ijinse1993/GetPointOfImpact2D/전체 회로도(schematic).png

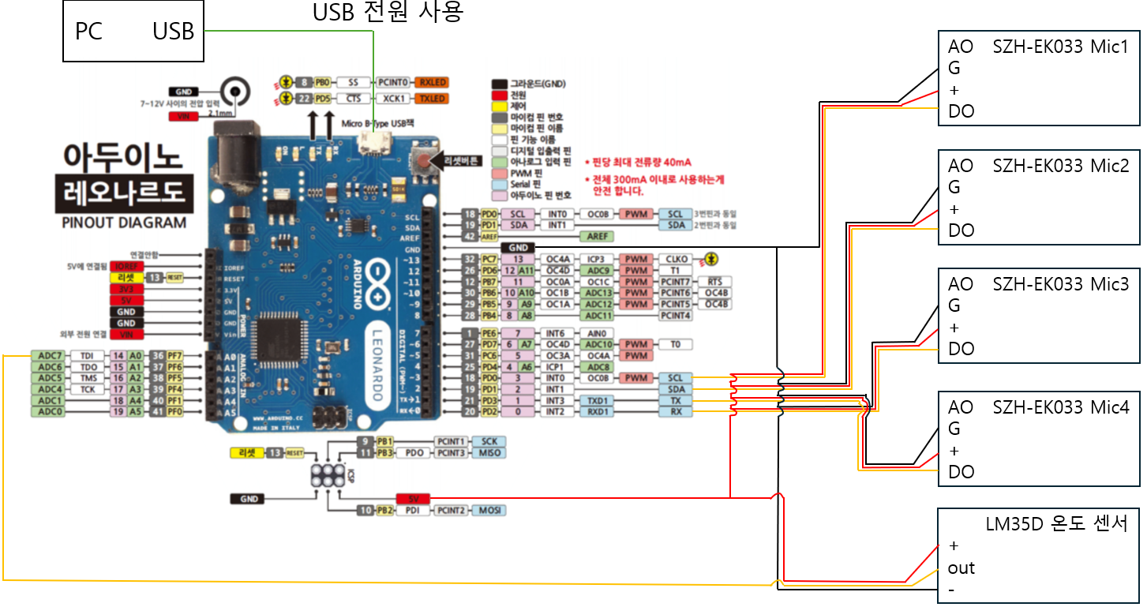
전체 회로도(schematic).png
