ijinse1993/GetPointOfImpact2D/GetPointOfImpact2D_ForLeonardo.ino

#include <math.h>
#include <AbsMouse.h>

#define PIN_DEBUG_CHECK 6
#define CHECK_MIC01_DISTANCE 0
/*
마이크 혹은 가속도센서 설치 위치(반드시 마이크를 탄착판에 밀착하여 설치)
센서 입력은 디지털 on/off 신호로 들어와야함
MIC1--------------------------MIC2
 |              +              |
 |                             |
 |-                           +|
 |                             |
 |              -              |
MIC3--------------------------MIC4
*/

//0,1,2,3,7 사용 가능
#define MIC_COUNT      4						//전체 마이크 갯수 (현재 알고리즘에서는 4개 고정)
#define PIN_MIC1       3            //외부 인터럽트 기능을 위해 고정
#define PIN_MIC2       2            //외부 인터럽트 기능을 위해 고정
#define PIN_MIC3       0            //외부 인터럽트 기능을 위해 고정
#define PIN_MIC4       1            //외부 인터럽트 기능을 위해 고정

//tuning ( * 표시는 필수로 환경에 맞게 변경 필요)
#define MIC_FS (16000000ul/64)              //sampling rate [Hz]
int TimerPrescaleVal = (0 << CS12) | (1 << CS11) | (1 << CS10); //16000000/64
float mic_width                       = 930;				  //마이크가 놓인 직사각형의 너비 [mm]   *
float mic_height                      = 390;          //마이크가 놓인 직사각형의 높이 [mm]   *
float Temperature                     = 22;           //기온, 소리속도 계산 목적이며 USING_LM35D_TEMP_SENSOR옵션이 켜지면 실시간으로 센서를 통해 온도값을 받음 ['C] *
int MonitorWidth                      = 3440;         //주 모니터의 가로 해상도 [pixel]  *
int MonitorHeight                     = 1440;         //주 모니터의 세로 해상도 [pixel]  *
uint32_t DelayForRemoveEcho           = 30;           //충격 인식 후 다시 인식 시작하기까지 딜레이 (잔향 제거)[millisecond]
float WaitAllInputDelay               = 2.05;         //너무 오래된 입력을 사용하지 않기 위한 리셋타임 게인
int MouseClickTime                    = 8;            //마우스 클릭 후 떼기까지 시간 [millisecond]
int MouseClickTimeRandomAmplitude     = 5;            //마우스 클릭 후 떼기까지 시간에 더해질 난수 시간 크기 [millisecond]
int MouseClickButton                  = MOUSE_LEFT;   //마우스 클릭 버튼 (좌클릭:MOUSE_LEFT,우클릭:MOUSE_LEFT,가운데 버튼 클릭:MOUSE_MIDDLE)

#define USING_LM35D_TEMP_SENSOR       1               //1 : LM35D 온도 센서 사용, 0 : 미사용 *
#define TEMP_AVERAGE_COUNT            30
int LM35D_PIN                         = A0;           //온도 센서값을 받을 ADC 핀

float v;                                  //탄착판에서 소리의 전달 속도  [mm/s]
unsigned int MicInputResetTime;           //너무 오래된 입력을 사용하지 않기 위한 리셋타임, WaitAllInputDelay*대각선 길이/v로 계산[sample]
uint32_t MicInputTime[MIC_COUNT];			    //마이크별 충격음을 인식했을 때 시간
char MicInputExist[MIC_COUNT];				    //마이크별 충경 인식 여부 (잔향 제거)
char MicInputCount = 0;                   //충격음을 인식한 마이크 개수
uint32_t NowTime = 0;                     //타이머로 세는 현재시간은 0.26초밖에 못세므로 타이머가 오버플로우로 초기화될때마다
                                          //타이머 시간 누적 계산하여 현재시간 표시
                                          //NowTime의 오버플로우는 30분마다 한번씩 나오므로 처리 안함
char MicInputOrder = 1;                   //마이크 들어온 순서를 쉽게 알기위한 변수


float TempData[TEMP_AVERAGE_COUNT];
int TempIndex = 0;
float TempAccum = 0;

char AdcFlag = 0;
uint16_t AdcVal = 0;

ISR(INT0_vect)
{
  if( MicInputExist[0] == 0 )
  {
    register unsigned int IntTime;
    IntTime = TCNT1;                        //타이머 시간 가져오기 
    MicInputExist[0] = MicInputOrder++;     //마이크 값을 입력 받았다는 표시와 더불어 받은 순서 표시
    MicInputTime[0] = NowTime + IntTime;    //현재 시간에 타이머 시간 추가하여 현재시간 갱신
    MicInputCount++;                        //마이크 받은 갯수 표시
    EIMSK &= 0xFF - (1 << INT0);            //계산 리셋 전까지 이 마이크 추가 입력 받지 않음
  }
}

ISR(INT1_vect)
{
  if( MicInputExist[1] == 0 )
  {
    register unsigned int IntTime;
    IntTime = TCNT1;
    MicInputExist[1] = MicInputOrder++;
    MicInputTime[1] = NowTime + IntTime;
    MicInputCount++;
    EIMSK &= 0xFF - (1 << INT1);
  }
}

ISR(INT2_vect)
{
  if( MicInputExist[2] == 0 )
  {
    register unsigned int IntTime;
    IntTime = TCNT1;
    MicInputExist[2] = MicInputOrder++;
    MicInputTime[2] = NowTime + IntTime;
    MicInputCount++;
    EIMSK &= 0xFF - (1 << INT2);
  }
}

ISR(INT3_vect)
{
  if( MicInputExist[3] == 0 )
  {
    register unsigned int IntTime;
    IntTime = TCNT1;
    MicInputExist[3] = MicInputOrder++;
    MicInputTime[3] = NowTime + IntTime;
    MicInputCount++;
    EIMSK &= 0xFF - (1 << INT3);
  }
}

ISR(TIMER1_OVF_vect)
{
  NowTime += 0x10000; //오버플로우 후니 0xFFFF가 아니라 0x10000이 맞는것 같음
	//NowTime변수의 오버플로우는 30분에 한번씩 발생하니 처리 안함

  #if USING_LM35D_TEMP_SENSOR
  if( ADCSRA & (1<<ADIF) )
  {
    AdcVal = ADC;
    AdcFlag = 1;
    ADCSRA |= (1<<ADIF);  //flag clear
    ADCSRA |= (1<<ADSC);  //ADC start
  }
  #endif
}

void InputOff()
{
  EIMSK = 0;  //인터럽트 금지
  TIMSK1 = 0;
}

void CalculateReset()
{
	int i;
  EIMSK = 0;  //인터럽트 금지
  TIMSK1 = 0;

  //현재 시간과 마이크 입력 여부 초기화
	for(i = 0 ;i < MIC_COUNT;i++) MicInputExist[i] = 0;
	NowTime = 0;
	MicInputCount = 0;
  MicInputOrder = 1;

  //External int 기존 입력 제거
  EIFR |= (1 << INTF3) | (1 << INTF2) | (1 << INTF1) | (1 << INTF0);

  //타이머 카운트 초기화
  TCCR1B &= 0xFF - ((1 << CS12) | (1 << CS11) | (1 << CS10));	//타이머 종료
  TCNT1 = 0;
  TIFR1 |= (1 << TOV1);
  TCCR1B |= TimerPrescaleVal;  //타이머 재시작

  //인터럽트 허용
  EIMSK = (1<<INT3) | (1<<INT2) | (1<<INT1) | (1<<INT0);
  TIMSK1 |= (0 << ICIE1) | (0 << OCIE1B) | (0 << OCIE1A) | (1 << TOIE1);		//
}

float TempMoveMean(float Temp)
{
  TempAccum -= TempData[TempIndex];
  TempData[TempIndex] = Temp / TEMP_AVERAGE_COUNT;
  TempAccum += TempData[TempIndex];
  TempIndex++;
  if(TempIndex >= TEMP_AVERAGE_COUNT) TempIndex = 0;
  return TempAccum;
}

void setup()
{
  int i;
  delay(100);

  randomSeed(analogRead(0));

  cli();    //모든 인터럽트 금지
  for(i = 0 ;i < MIC_COUNT;i++) MicInputExist[i] = 0;
	NowTime = 0;
	MicInputCount = 0;
  
  //마이크 입력핀 입력 모드
  pinMode(PIN_MIC1, INPUT);
  pinMode(PIN_MIC2, INPUT);
  pinMode(PIN_MIC3, INPUT);
  pinMode(PIN_MIC4, INPUT);
  //pinMode(PIN_DEBUG_CHECK, OUTPUT);

  //디버그용 시리얼 초기화
  Serial.begin(250000);

  //External int 초기화
  //INT0, INT1 , INT2, INT3 rising edge 검출
																												  
  
											   
	EICRA = (1<<ISC31) | (0<<ISC30) | (1<<ISC21) | (0<<ISC20) | (1<<ISC11) | (0<<ISC10) | (1<<ISC01) | (0<<ISC00);
  EICRB = 0;
	EIMSK = (1<<INT3) | (1<<INT2) | (1<<INT1) | (1<<INT0);  //인터럽트 허용

  //타이머 초기화
  //normal모드, 오버플로우 인터럽트 허용
  //prescale 64 : 250kHz
  TCCR1A = (0 << WGM11) | (0 << WGM10);
  TCCR1B = (0 << ICNC1) | (0 << ICES1) | (0 << WGM13) | (0 << WGM12);
  TCCR1C = 0;
  TCNT1 = 0;
  TIMSK1 = (0 << ICIE1) | (0 << OCIE1B) | (0 << OCIE1A) | (1 << TOIE1);		//
  TCCR1B |= TimerPrescaleVal;

  sei();  //인터럽트 허용

  #if USING_LM35D_TEMP_SENSOR
  analogReference(DEFAULT);

  for(i = 0; i < TEMP_AVERAGE_COUNT; i++)
  {
    AdcVal = analogRead(LM35D_PIN);

    //읽어 들인 값을 현재 섭씨 온도값으로 변환한다.
    Temperature = TempMoveMean((5.0 * AdcVal * 100.0)/1024);
    delay(10);
  }
  ADCSRA |= (1<<ADIF);  //flag clear
  ADCSRA |= (1<<ADSC);  //ADC start
  #endif

  //기온을 이용하여 공기중 소리 속도 계산
  v = 1000 * 331.3 * sqrt( (Temperature+273.15) / 273.15 );
  //v = 487680;

  //너무 오래된 입력을 사용하지 않기 위한 리셋타임[second]
  //외부 노이즈로 마이크중 일부만 소리가 입력되었다고 인식되었을 때 이 입력을 지워주기 위함
  //가장 먼 거리인 대각선 거리보다 1.05배 긴 거리의 시간차보다 더 오래된 신호가 있으면 기존 입력 초기화
  MicInputResetTime = (unsigned int)(
    WaitAllInputDelay * sqrt(mic_width*mic_width + mic_height*mic_height)
    * (MIC_FS / v) + 0.5
  );

  //PC에 절대값 마우스 입력을 위한 라이브러리 초기화
  AbsMouse.init(MonitorWidth, MonitorHeight);
}

void CalculatePos(float t01, float t23, float t02, float width, float height, int *x, int *y)
{
  float X, Y, tmp;

  if( (abs(t01) < 1e-8) || (abs(t23) < 1e-8) )												//탄착점이 Y축 위에 존재
	{
		float S;
		X = 0.0;

		S = v*v*t02*t02;
		tmp = ((height*height+width*width)*S-S*S) / (4*height*height-4*S);
		if(tmp < 0)
  	{
			tmp = 0;
		}

		if(t02 > 0) Y = -sqrt( tmp );
		else Y = sqrt( tmp );
  }else if( (abs(t02) < 1e-8) || (abs(t01-t23) < 1e-8) )							//탄착점이 X축 위에 존재
	{
		float S;
		Y = 0;

		S = v*v*t23*t23;
		tmp = ((width*width+height*height)*S-S*S) / (4*width*width-4*S);
		if(tmp < 0)
		{
			tmp = 0;
		}

		if(t23 > 0) X = sqrt( tmp );
		else X = -sqrt( tmp );
	}else{
    float algo_A1,algo_B1,algo_A2,algo_B2, alpha, beta, gamma;
  
		algo_A1 = t01 * t01;
		algo_A2 = t23 * t23;
		algo_B1 = ( 4 * algo_A1 ) / ( width*width - v*v*algo_A1 );
		algo_B2 = ( 4 * algo_A2 ) / ( width*width - v*v*algo_A2 );
		alpha = algo_B1 - algo_B2;
		beta = -height * (algo_B1 + algo_B2);
		gamma = (algo_B1 - algo_B2) * height * height / 4 + algo_A1 - algo_A2;

		tmp = beta*beta-4*alpha*gamma;
		if(tmp < 0)
		{
			tmp = 0;
		}
		Y = (-beta - sqrt( tmp ) ) / (2 * alpha);

		tmp = 1 + ( 4 * (Y-height/2)*(Y-height/2) / ( width*width-v*v*t01*t01) );
		if(tmp < 0)
		{
			tmp = 0;
		}

		X = v*t01*sqrt( tmp ) / 2;
	}

  if(x)
  {
    *x = (int)(X+0.5);
	  if( *x > width/2)		*x = width/2;      //결과값 최대치 제한
	  else if( *x < -width/2)	*x = -width/2;
  }
		
  if(y)
  {
    *y = (int)(Y+0.5);
    if( *y > height/2)	*y = height/2;      //결과값 최대치 제한
		else if( *y < -height/2)	*y = -height/2;
  }
}

void loop()
{
  #if USING_LM35D_TEMP_SENSOR
  if(AdcFlag)
  {
    AdcFlag = 0;
    //읽어 들인 값을 현재 섭씨 온도값으로 변환한다.
    Temperature = TempMoveMean( (5.0 * AdcVal * 100.0)/1024 );
    v = 1000 * 331.3 * sqrt( (Temperature+273.15) / 273.15 );
    //Serial.println(Temperature);
  }
  #endif

  if(MicInputCount >= MIC_COUNT)
	{
    int i;
    float t01, t23, t02, t13;
    int32_t tmp2;
    int x, y;
    InputOff();
    //digitalWrite(PIN_DEBUG_CHECK, HIGH);

    #if CHECK_MIC01_DISTANCE
    //------------------마이크 시간차 계산
    tmp2 = MicInputTime[0] - MicInputTime[1];
		//t01 = tmp2 * v / MIC_FS;
    //Serial.println(t01);
    t01 = mic_width / tmp2 * MIC_FS;
    Serial.println(t01);
    //-----------------------------------
		#else

    //------------------탄착 지점 계산 코드
    //x축 연산 결과는 잘맞으나 y축 연산 결과는 영 잘맞지 않아 x축 좌표를 구하고 90도 돌려서 다시 x축 좌표를 구하는것으로
    //y축 좌표 계산함
    tmp2 = MicInputTime[0] - MicInputTime[1];
		t01 = ((float)tmp2) / MIC_FS;
    tmp2 = MicInputTime[2] - MicInputTime[3];
		t23 = ((float)tmp2) / MIC_FS;
    tmp2 = MicInputTime[0] - MicInputTime[2];
		t02 = ((float)tmp2) / MIC_FS;

    CalculatePos(t01, t23, t02, mic_width, mic_height, &x, (int *)0);
    //-----------------------------------
    //3 -> 1
		//1 -> 2
		//4 -> 3
		//2 -> 4
    tmp2 = MicInputTime[2] - MicInputTime[0];
		t01 = ((float)tmp2) / MIC_FS;
    tmp2 = MicInputTime[3] - MicInputTime[1];
		t23 = ((float)tmp2) / MIC_FS;
    tmp2 = MicInputTime[2] - MicInputTime[3];
		t02 = ((float)tmp2) / MIC_FS;

    CalculatePos(t01, t23, t02, mic_height, mic_width, &y, (int *)0);

    #if 0
    Serial.print("X:");
    Serial.println(x);
    Serial.print("Y:");
    Serial.println(y);
    #else
    AbsMouse.move(
      (uint16_t)((x + mic_width/2) * MonitorWidth / mic_width + 0.5),
      (uint16_t)((mic_height/2 - y) * MonitorHeight / mic_height + 0.5)
    );
    AbsMouse.press(MouseClickButton);
    delay(MouseClickTime);
    delay( random(MouseClickTimeRandomAmplitude) );
    AbsMouse.release(MouseClickButton);

    //Serial.print("X:");
    //Serial.println( (uint16_t)((x + mic_width/2) * MonitorWidth / mic_width + 0.5) );
    //Serial.print("Y:");
    //Serial.println( (uint16_t)((mic_height/2 - y) * MonitorHeight / mic_height + 0.5) );
    #endif
    
    #endif
    delay(DelayForRemoveEcho);  //잔향이 끝날때까지 대기

		CalculateReset();																				//리셋
    //digitalWrite(PIN_DEBUG_CHECK, LOW);
	}
  else if(MicInputCount > 0)					//측정 시간이 오래되면 리셋
	{
    #if CHECK_MIC01_DISTANCE==0
    int i;
    for(i=0;i<MIC_COUNT;i++)
    {
      if(MicInputExist[i] == 1)
      {
        register unsigned int IntTime;
        uint32_t tmp2;
        IntTime = TCNT1;
        tmp2 = (NowTime + IntTime) - MicInputTime[i];
        if( tmp2 >= MicInputResetTime )
        {
          CalculateReset();
        }
        break;
      }
    }
    #endif
	}
}
