ijinse1993/GetPointOfImpact2D/(commit log)

2024-08-30 Update GetPointOfImpact2D_ForLeonardo.ino
    계산 초기화 중간 인터럽트 활성화 코드 제거
2024-09-01 Update GetPointOfImpact2D_ForLeonardo.ino
    MicInputResetTime 변수관련 버그 수정.
    온도센서 추가
    마우스 클릭관련 튜닝 요소 추가
    연산량을 줄이기위한 MicInputResetTime를 샘플단위로 변경
    [GetPointOfImpact2D_ForLeonardo.ino]
2024-09-01 Update GetPointOfImpact2D_ForLeonardo.ino
    mic_width, mic_height를 float으로 변경
2024-09-02 Update GetPointOfImpact2D_ForLeonardo.ino
    온도센서 디폴트 비활성화
2024-09-21 Update GetPointOfImpact2D_ForLeonardo.ino
    change adc timing
2024-10-05 Update GetPointOfImpact2D_ForLeonardo.ino
    디버그 모드 추가
2024-10-05 Update GetPointOfImpact2D_ForLeonardo.ino
    온도센서 설정에 설정 필요 표시(*) 추가
2024-10-05 Update README.md
    마이크 세팅방법에 대한 설명 수정
2025-01-26 Update GetPointOfImpact2D_ForLeonardo.ino
    클릭 시간에 난수 추가
